RoboAG/eagle_voltageMonitoring/README.md

# eagle_voltageMonitoring
Simple voltage monitoring circuit
