RoboAG/eagle_voltageMonitoring/export/all.png

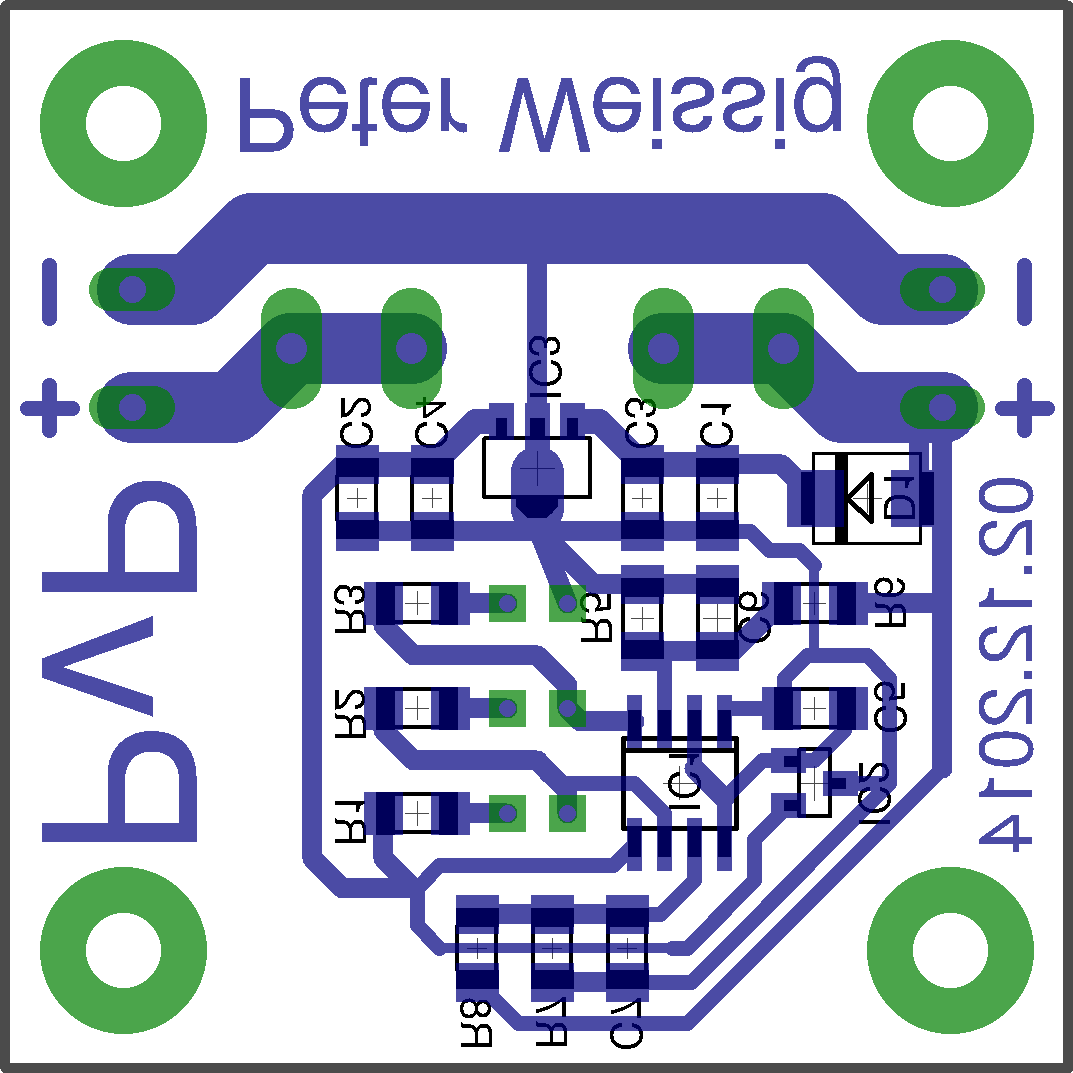
export/all.png
