RoboAG/eagle_voltageMonitoring/export/circuit.png

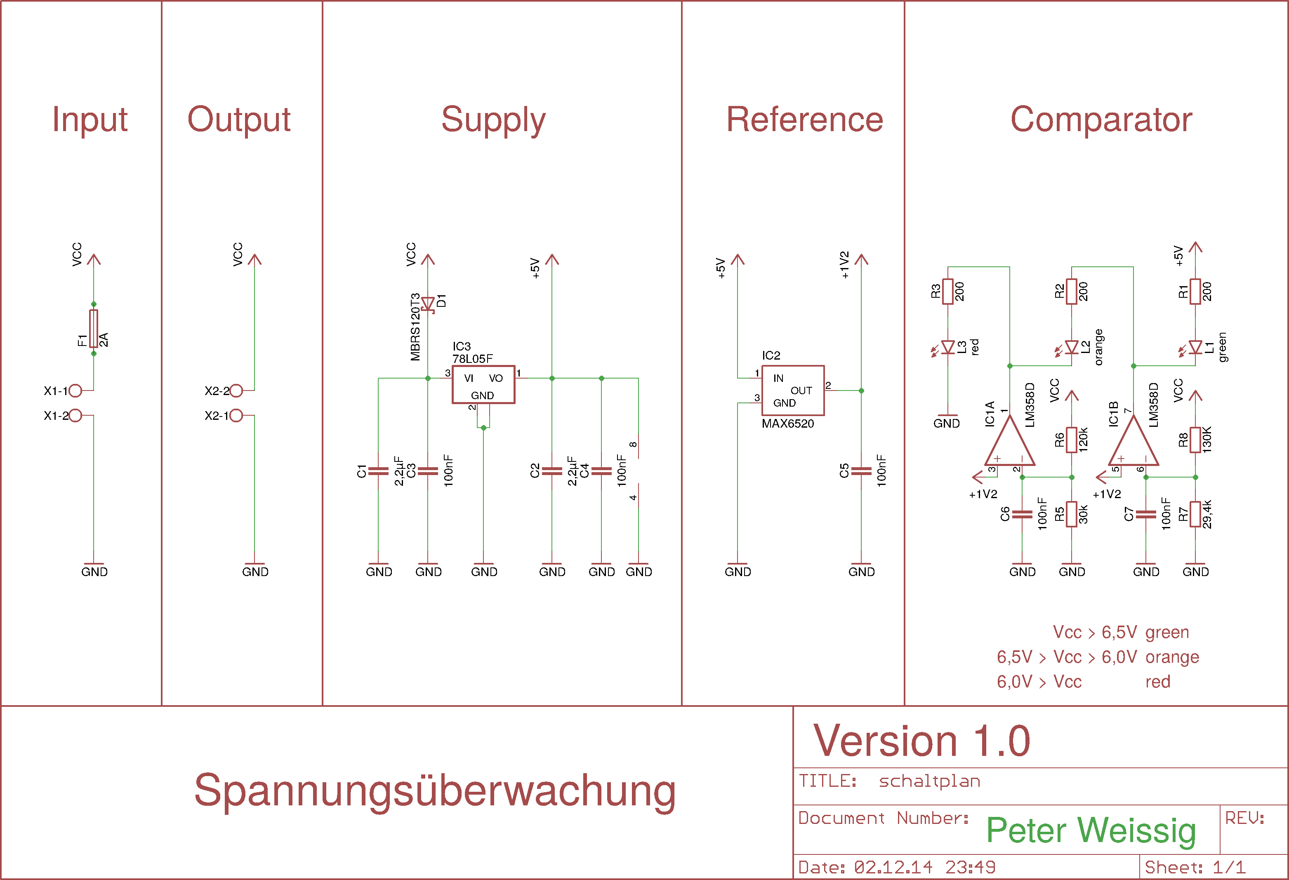
export/circuit.png
