RoboAG/eagle_voltageMonitoring/export/layout.png

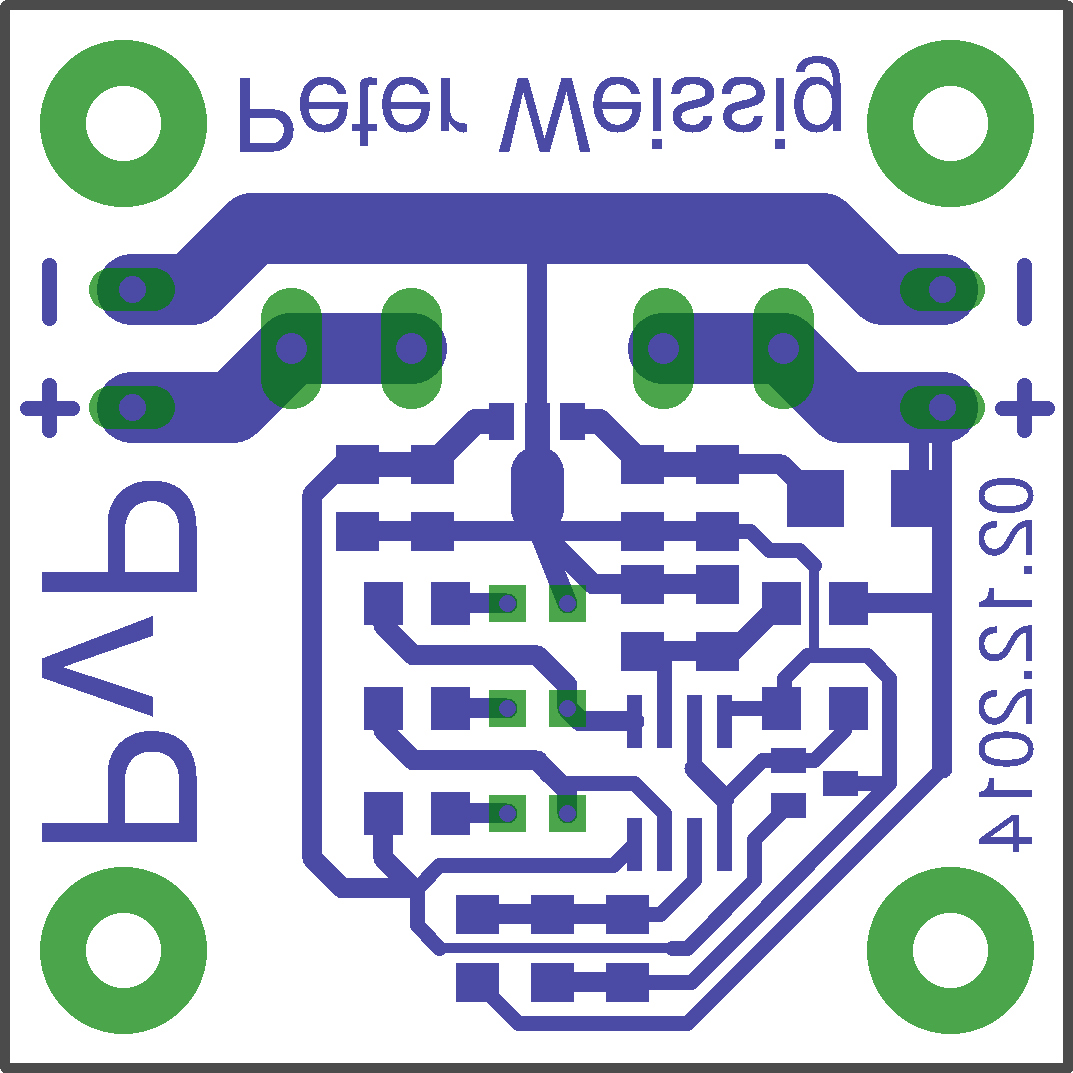
export/layout.png
