RoboAG/eagle_voltageMonitoring/parts/parts.ods

Gruppe | Bauelement | Wert | Beschreibung | Bestellung (www.reichelt.de)
Wider- Stände | R1 – R3 | 200 | SMD 1206; ¼ W; 5% | SMD 1/4W 200 (http://www.reichelt.de/SMD-1206-100-Ohm-910-Ohm/SMD-1-4W-200/3/index.html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) | 3 | 0,10 € | 0,31 €
 | R7 | 29,4k | SMD 1206; ¼ W; 0,1% | SPR-1206 29,4K (http://www.reichelt.de/SMD-0-1-1206-1-0-kOhm-91-0-kOhm/SPR-1206-29-4K/3/index.html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,4K) | 1 | 0,14 € | 0,14 €
 | R5 | 30k | SMD 1206; ¼ W; 0,1% | SPR-1206 30,0K (http://www.reichelt.de/SMD-0-1-1206-1-0-kOhm-91-0-kOhm/SPR-1206-30-0K/3/index.html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,0K) | 1 | 0,14 € | 0,14 €
 | R6 | 120k | SMD 1206; ¼ W; 0,1% | SPR-1206 120K (http://www.reichelt.de/SMD-0-1-1206-100-kOhm-1-0-MOhm/SPR-1206-120K/3/index.html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) | 1 | 0,14 € | 0,14 €
 | R8 | 130k | SMD 1206; ¼ W; 0,1% | SPR-1206 130K (http://www.reichelt.de/SMD-0-1-1206-100-kOhm-1-0-MOhm/SPR-1206-130K/3/index.html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) | 1 | 0,14 € | 0,14 €
Kond. | C1 – C2 | 2,2µF | SMD 1206; kerko; 50V | X7R-G1206 2,2/50 (http://www.reichelt.de/Vielschicht-SMD-G1206-High-Cap/X7R-G1206-2-2-50/3/index.html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,2/50) | 2 | 0,09 € | 0,18 €
 | C3 – C7 | 100nF | SMD 1206; kerko; 63V | X7R-G1206 100N (http://www.reichelt.de/Vielschicht-SMD-G1206/X7R-G1206-100N/3/index.html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) | 5 | 0,05 € | 0,25 €
Dioden | D1 | 1A | SMD; 20V; 1A; schottky | MBRS 120 SMD (http://www.reichelt.de/MR-MURS-P600-RGP-Dioden/MBRS-120-SMD/3/index.html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) | 1 | 0,13 € | 0,13 €
Leds | L1 | grün | 3mm; low current | LED 3MM 2MA GN (http://www.reichelt.de/LEDs-Low-Current/LED-3MM-2MA-GN/3/index.html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) | 1 | 0,08 € | 0,08 €
 | L2 | orange | 3mm; low current | LED 3MM 2MA GE (http://www.reichelt.de/LEDs-Low-Current/LED-3MM-2MA-GE/3/index.html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) | 1 | 0,09 € | 0,09 €
 | L3 | rot | 3mm; low current | LED 3MM 2MA RT (http://www.reichelt.de/LEDs-Low-Current/LED-3MM-2MA-RT/3/index.html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) | 1 | 0,08 € | 0,08 €
ICs | IC1 | OPV | SMD; OPV; 2x | LM 358 SMD (http://www.reichelt.de/SMD-0-1-1206-100-kOhm-1-0-MOhm/SPR-1206-120K/3/index.html?ACTION=3;ARTICLE=18716;SEARCH=LM%20358%20SMD) | 1 | 0,16 € | 0,16 €
 | IC2 | Spg-Ref. | SMD; 1,2V; 70µA | MAX 6120 EUR (http://www.reichelt.de/ICs-TLC-TSA-/TS-78L05-ACY/3/index.html?ACTION=3;ARTICLE=148595;SEARCH=MAX%206120%20EUR) | 1 | 3,15 € | 3,15 €
 | IC3 | Spg-Regler | SMD; 5V; 0,1A | TS 78L05 ACY (http://www.reichelt.de/ICs-TLC-TSA-/TS-78L05-ACY/3/index.html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) | 1 | 0,23 € | 0,23 €
Anschl. | X1 – X2 | Schrauben | 2x; 5,08mm; | AKL101-02 (http://www.reichelt.de/RIA-Stecksystem/AKL-101-02/3/index.html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) | 2 | 0,31 € | 0,62 €
 | F1 | Sicherung | 2x Sicherungshalter | PL 120000 (http://www.reichelt.de/Sicherungshalter/PL-120000/3/index.html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) | 2 | 0,06 € | 0,12 €
Extras | Sicherung |  | 1A; Mittelsträge | MTR. 1,0A (http://www.reichelt.de/5x20mm-Feinsicherungen/MTR-1-0A/3/index.html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,0A) | 0 | 0,32 € | 0,00 €
 | Sicherung |  | 2A; Mittelsträge | MTR. 2,0A (http://www.reichelt.de/5x20mm-Feinsicherungen/MTR-2-0A/3/index.html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,0A) | 0 | 0,32 € | 0,00 €
 | Sicherung |  | 2A; Mittelsträge | MTR. 4,0A (http://www.reichelt.de/5x20mm-Feinsicherungen/MTR-4-0A/3/index.html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,0A) | 0 | 0,32 € | 0,00 €
 |  |  |  | Summe | 5,96 €
