RoboAG/eagle_voltageMonitoring/export/parts_bottom.png

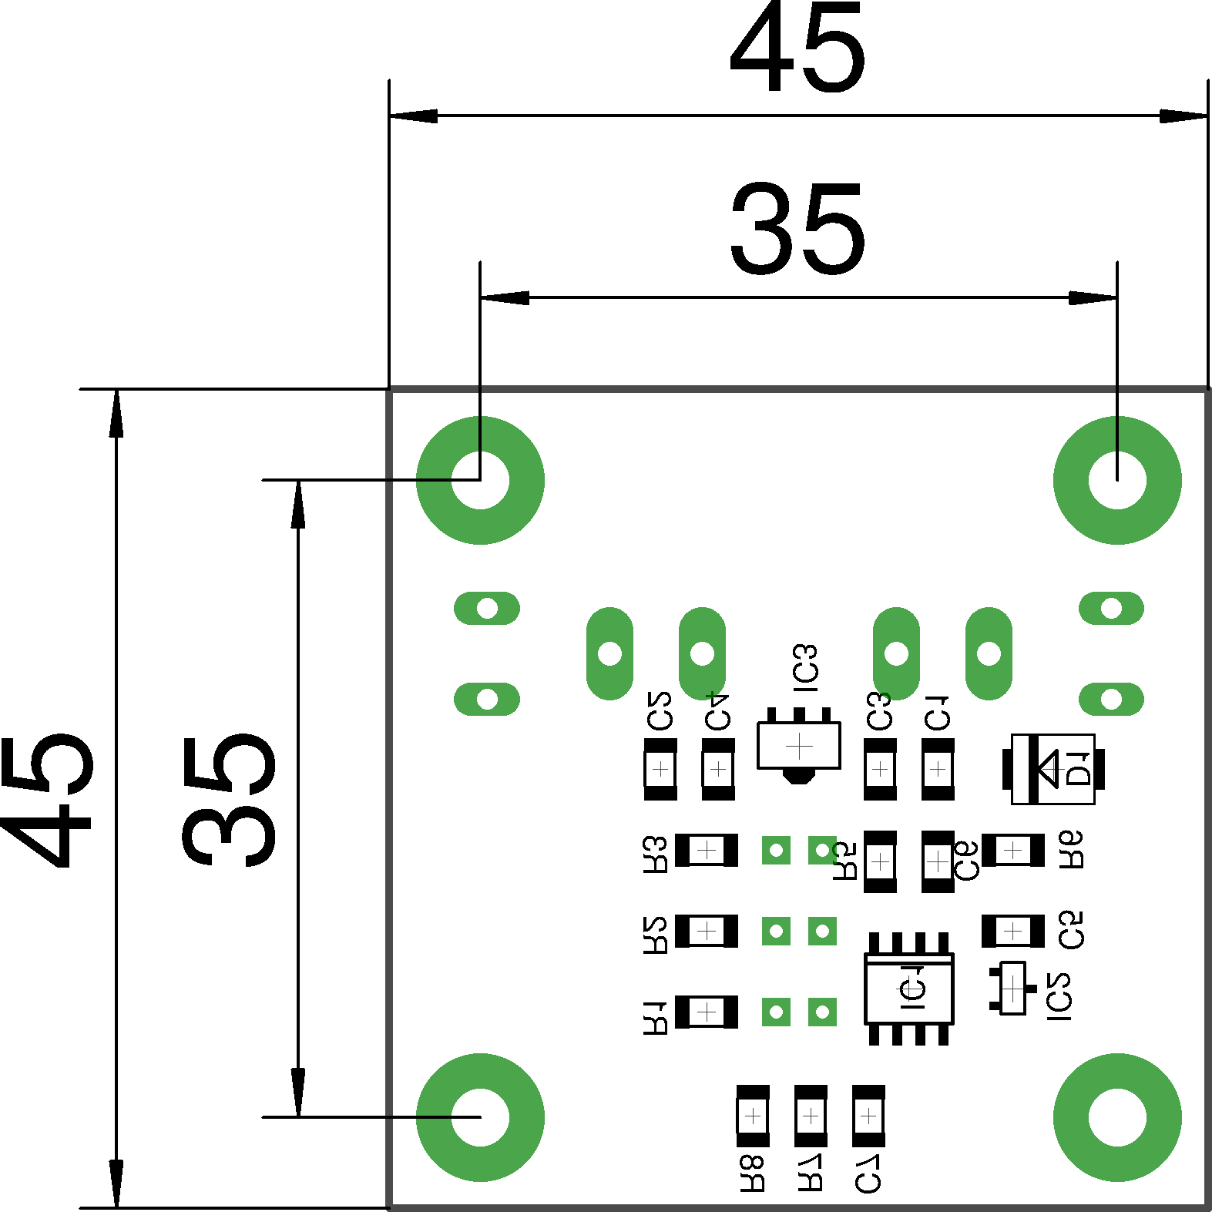
export/parts_bottom.png
