RoboAG/eagle_voltageMonitoring/export/parts_top.png

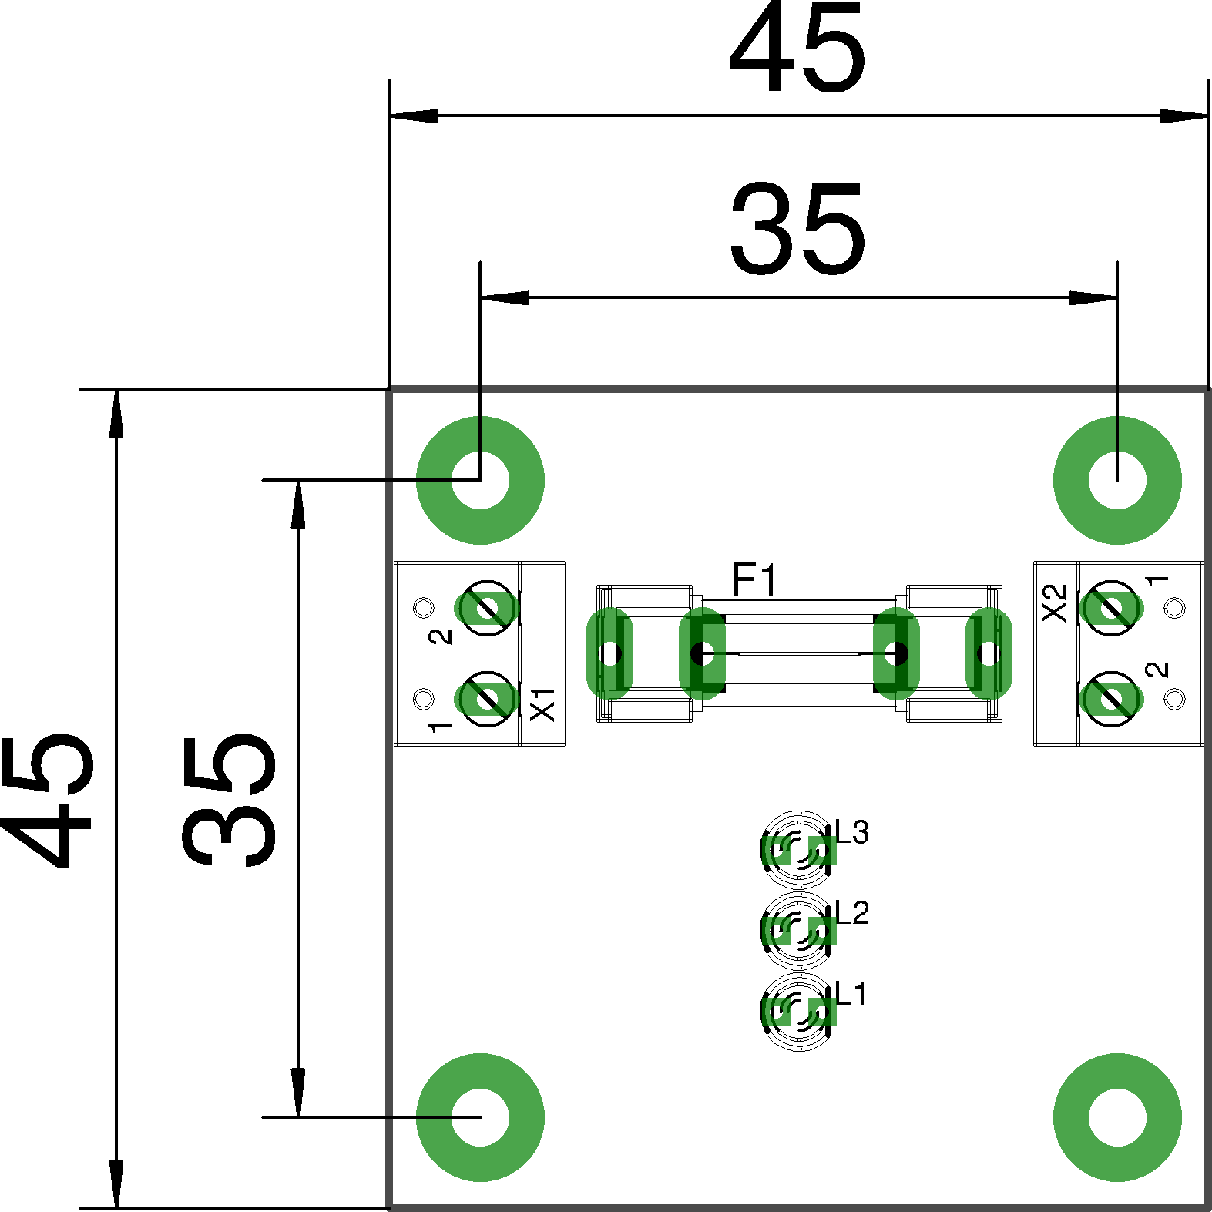
export/parts_top.png
