RoboAG/eagle_voltageMonitoring/parts/parts.pdf

# Bauteile Spannungsüberwachung

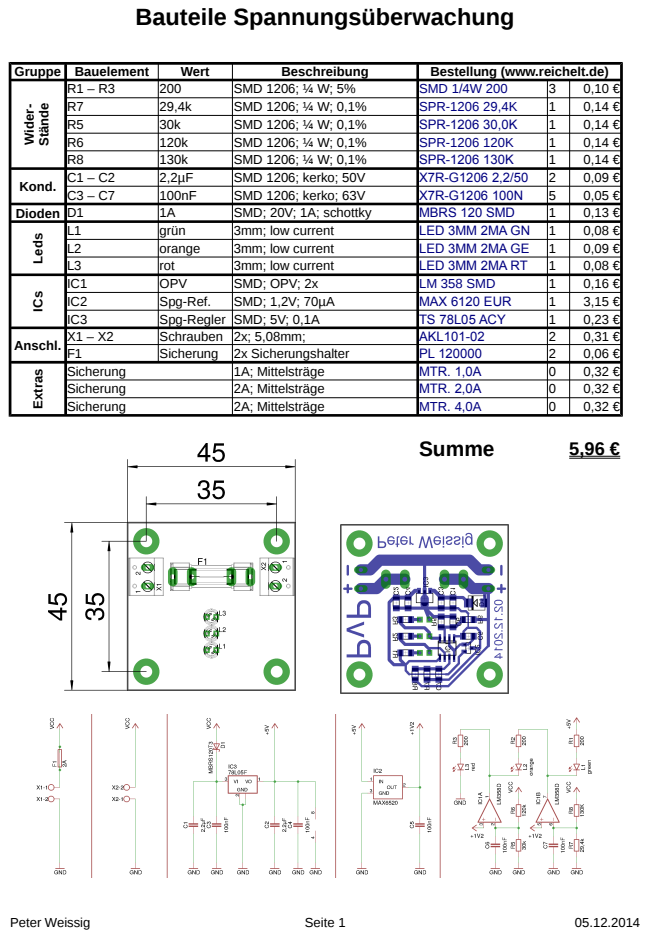
[picture p6: page 1]
