RoboAG/eagle_voltageMonitoring/export/circuit.pdf

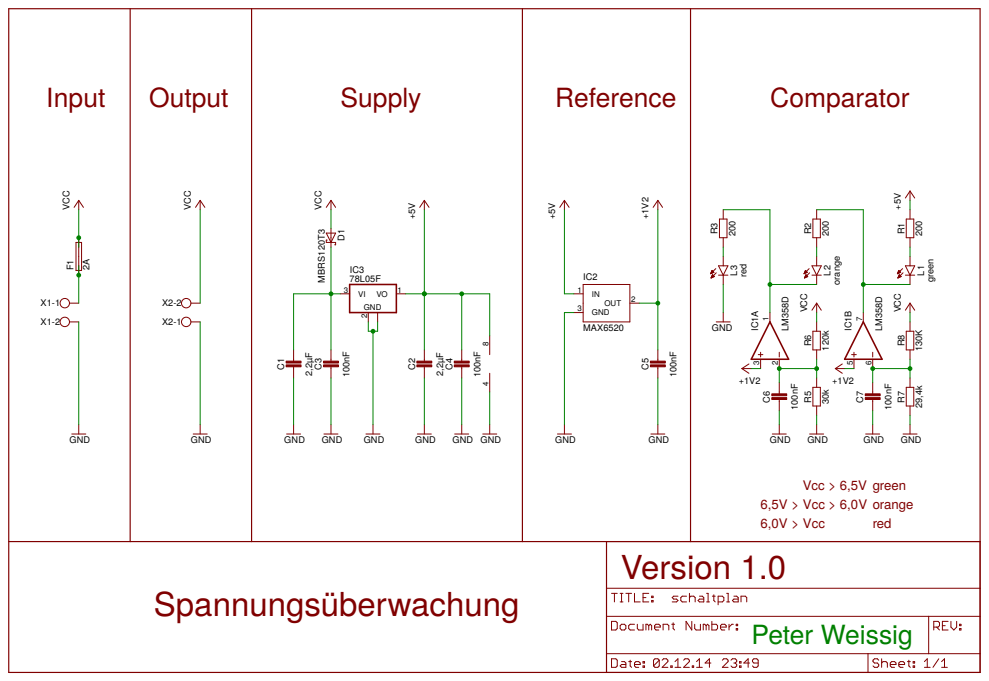
[picture p7: page 1]
