RoboAG/eagle_voltageMonitoring/circuit/circuit.brd

## EAGLE design circuit/circuit.brd (2017-11-26)

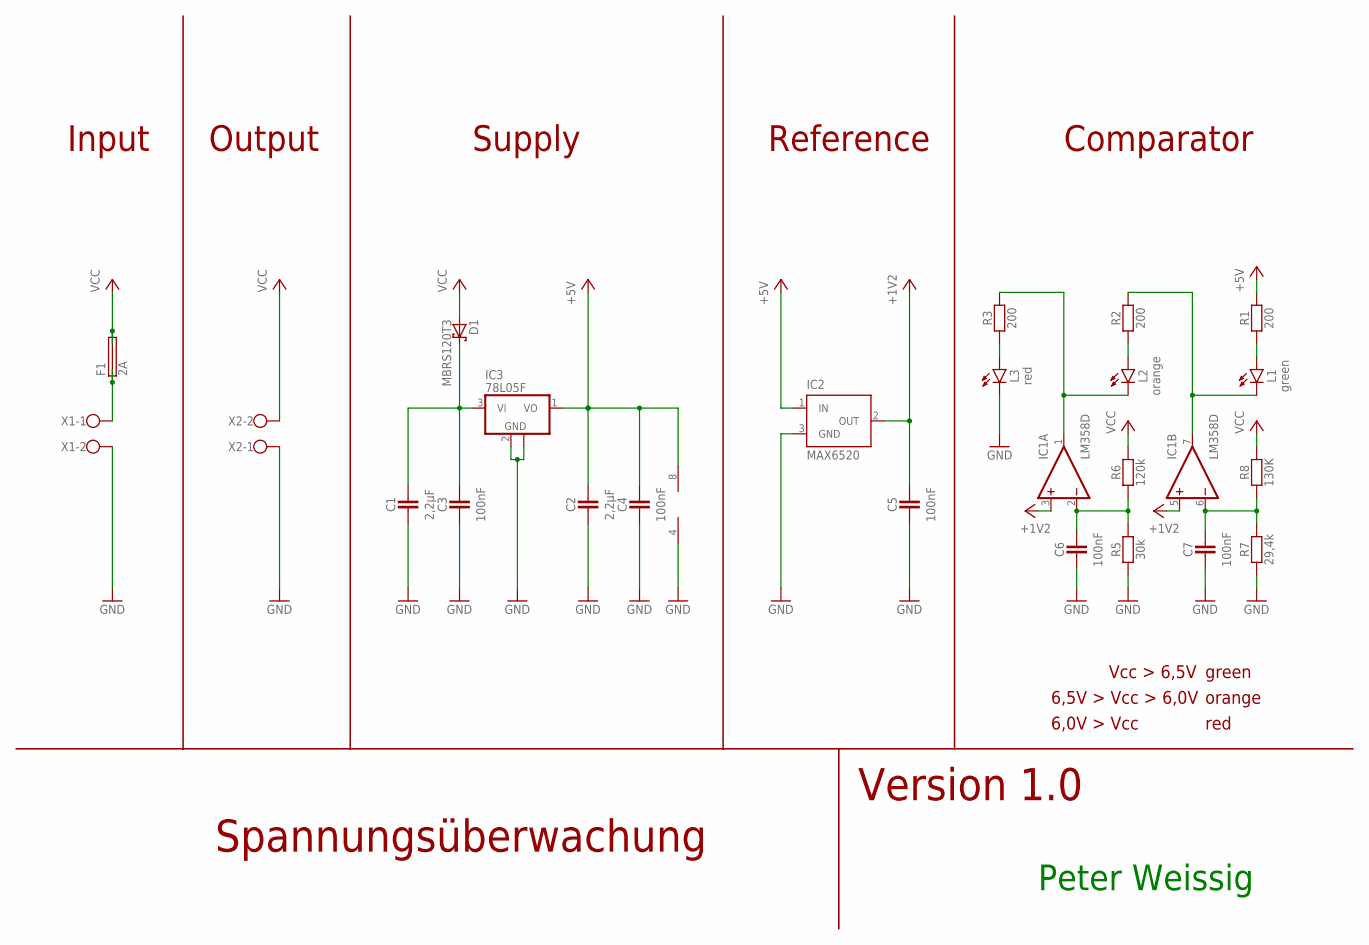
[picture p8: schematic circuit.sch]

Parts:
C1, C2: 2,2µF; SMD_1206
C3, C4, C5, C6, C7: 100nF; SMD_1206
D1: MBRS120T3; SMB
F1: 2A; SHK20L
IC1: LM358D; SO08
IC2: MAX6520; SOT23
IC3: 78L05F; SOT89
L1: green; LED_3MM
L2: orange; LED_3MM
L3: red; LED_3MM
R1, R2, R3: 200; SMD_1206
R5: 30k; SMD_1206
R6: 120k; SMD_1206
R7: 29,4k; SMD_1206
R8: 130K; SMD_1206
X1, X2: W237-102

Connections:
+3V3: C5.1, IC1.3 (+IN), IC1.5 (+IN), IC2.2 (OUT)
+5V: C2.1, C4.1, IC1.8 (V+), IC2.1 (IN), IC3.1 (VO), R1.1
GND: C1.2, C2.2, C3.2, C4.2, C5.2, C6.2, C7.2, IC1.4 (V-), IC2.3 (GND), IC3.2 (GND), IC3.2@1 (GND), L3.K (C), R5.1, R7.1, X1.2, X2.1
unnamed: C6.1, IC1.2 (-IN), R5.2, R6.1
unnamed: F1.1A, F1.1B, X1.1
unnamed: C7.1, IC1.6 (-IN), R7.2, R8.1
unnamed: C1.1, C3.1, D1.C, IC3.3 (VI)
unnamed: L1.A, R1.2
unnamed: IC1.7 (OUT), L1.K (C), R2.1
unnamed: L3.A, R3.2
unnamed: IC1.1 (OUT), L2.K (C), R3.1
unnamed: L2.A, R2.2
VCC: D1.A, F1.2A, F1.2B, R6.2, R8.2, X2.2

Notes on the sheet:
Input
Spannungsüberwachung
Peter Weissig
Version 1.0
Supply
Comparator
Output
Reference
Vcc > 6,5V
6,5V > Vcc > 6,0V
6,0V > Vcc
green
orange
red

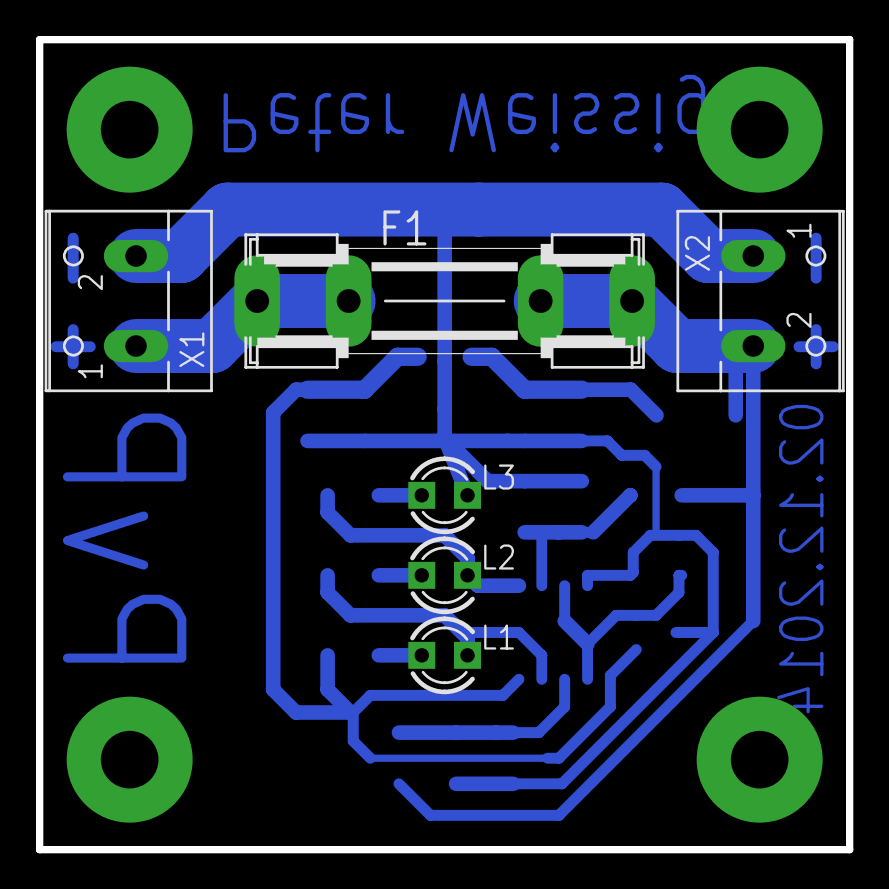
[picture p9: board circuit.brd from above]

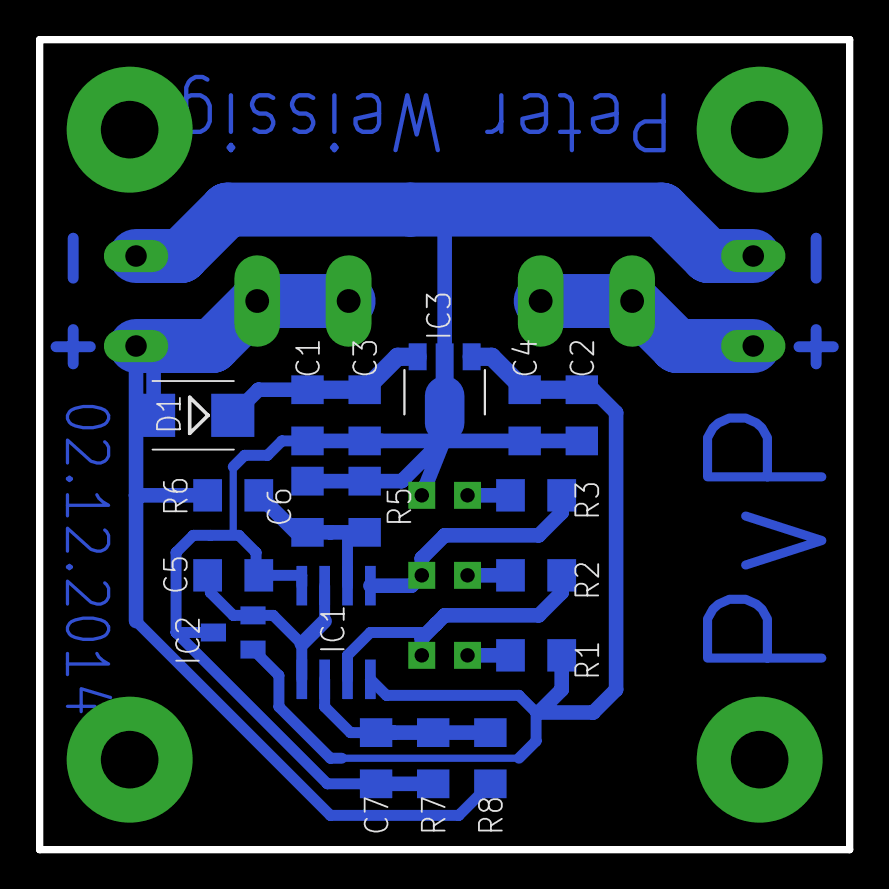
[picture p10: board circuit.brd from below]

Board: 2 copper layers, 45.0 x 45.0 mm, 24 parts (18 on the bottom side), 13 nets.
